garrettsworkshop/MacClassicRAMCard/Documentation/FrontIsom.png

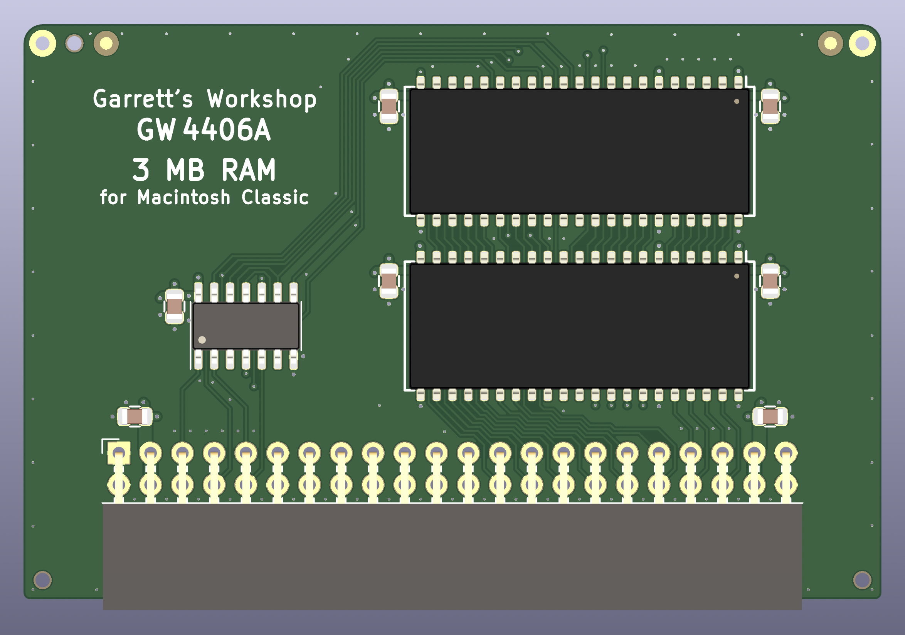
Documentation/FrontIsom.png
