garrettsworkshop/MacClassicRAMCard/Documentation/FrontIsomTransparent.png

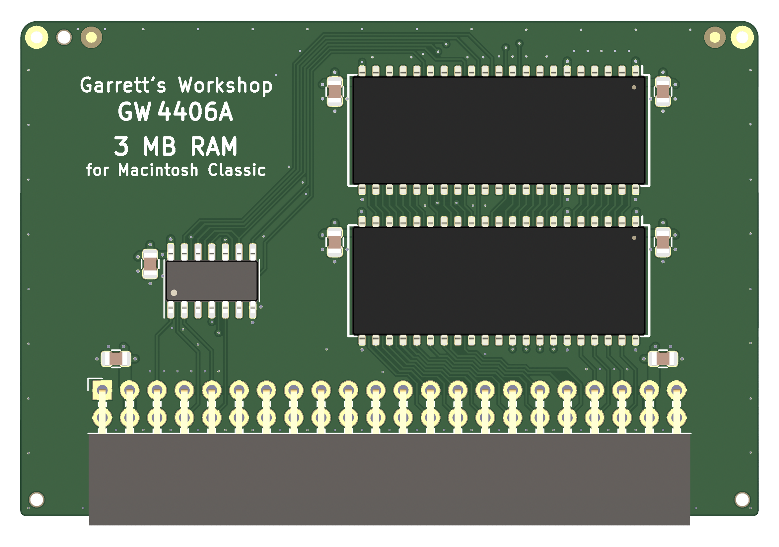
Documentation/FrontIsomTransparent.png
