garrettsworkshop/MacClassicRAMCard/Documentation/NewFrontIsom.png

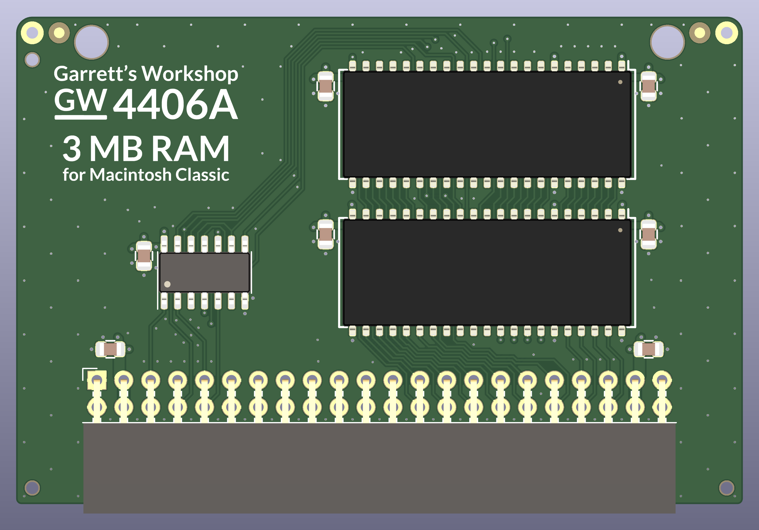
Documentation/NewFrontIsom.png
