garrettsworkshop/MacClassicRAMCard/Documentation/Schematic.png

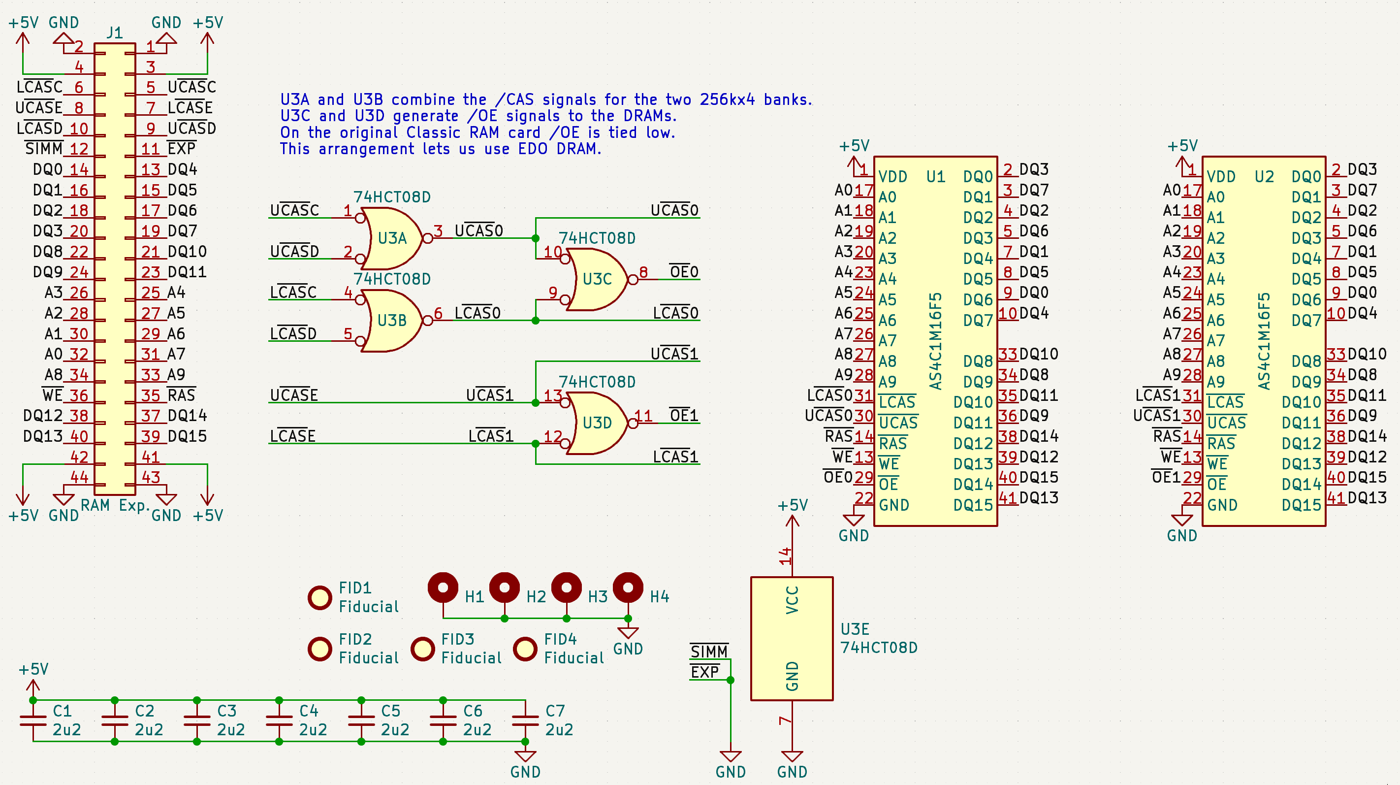
Documentation/Schematic.png
