garrettsworkshop/MacClassicRAMCard/Documentation/Schematic.pdf

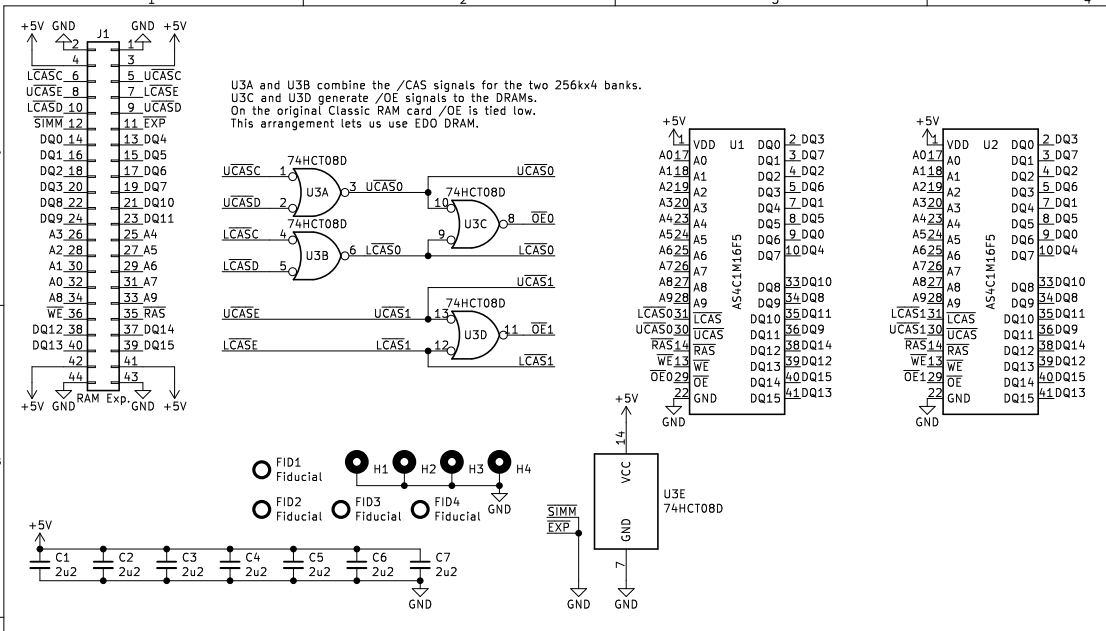
[picture p5: page 1]
