garrettsworkshop/MacClassicRAMCard/MacClassicRAMCard.kicad_pcb

## KiCad design MacClassicRAMCard.kicad_pcb (2022-08-10)

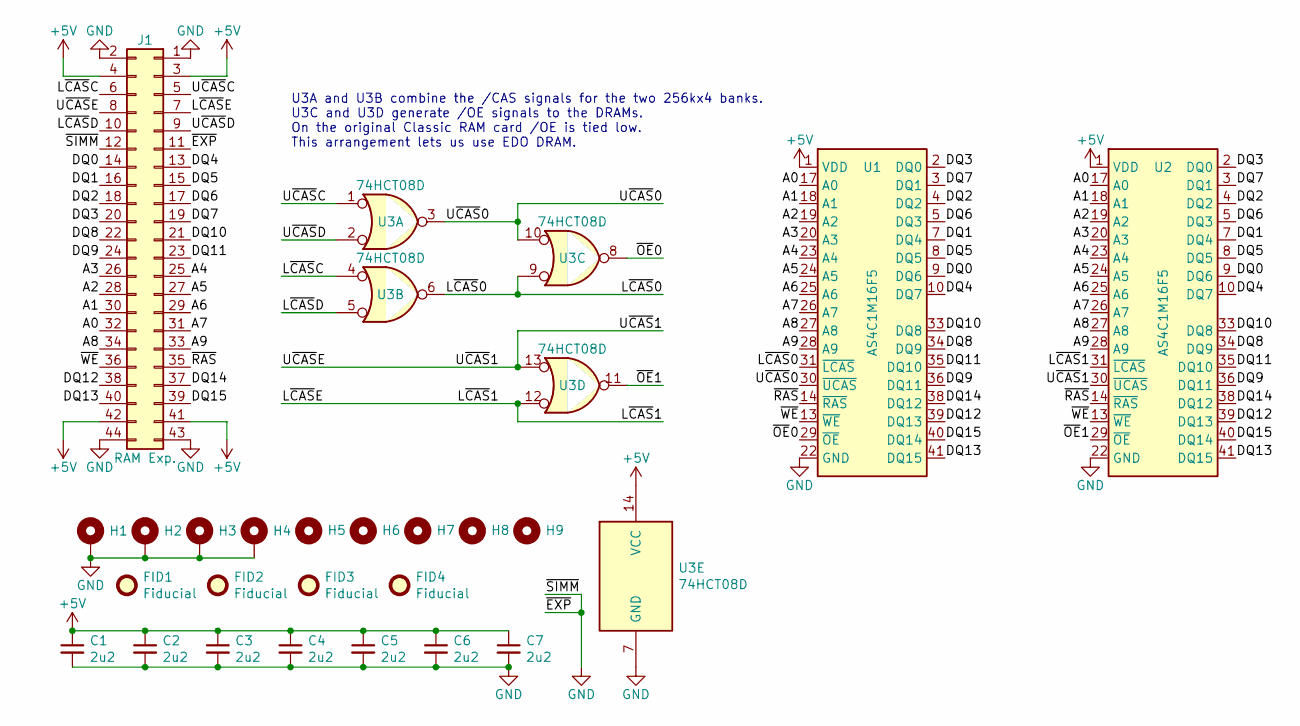
[picture p6: schematic MacClassicRAMCard.kicad_sch, GW4406A]

Parts:
C1, C2, C3, C4, C5, C6, C7: 2u2; C_0805
FID1, FID2, FID3, FID4: Fiducial
H1, H2, H3, H4: PasteHole_1.1mm_PTH
H5, H6, H7: PasteHole_1.152mm_NPTH
H8, H9: PasteHole_3mm_NPTH
J1: RAM Exp.; PinSocket_2x22_P2.54mm_Horizontal
U1, U2: AS4C1M16F5; SOJ-42_400mil
U3: 74HCT08D; SOIC-14_3.9mm

Connections:
+5V: C1.1, C2.1, C3.1, C4.1, C5.1, C6.1, C7.1, J1.3, J1.4, J1.41, J1.42, U1.1 (VDD), U1.6 (VDD), U1.21 (VDD), U2.1 (VDD), U2.6 (VDD), U2.21 (VDD), U3.14 (VCC)
/A0: J1.32, U1.17 (A0), U2.17 (A0)
/A1: J1.30, U1.18 (A1), U2.18 (A1)
/A2: J1.28, U1.19 (A2), U2.19 (A2)
/A3: J1.26, U1.20 (A3), U2.20 (A3)
/A4: J1.25, U1.23 (A4), U2.23 (A4)
/A5: J1.27, U1.24 (A5), U2.24 (A5)
/A6: J1.29, U1.25 (A6), U2.25 (A6)
/A7: J1.31, U1.26 (A7), U2.26 (A7)
/A8: J1.34, U1.27 (A8), U2.27 (A8)
/A9: J1.33, U1.28 (A9), U2.28 (A9)
/DQ0: J1.14, U1.9 (DQ6), U2.9 (DQ6)
/DQ1: J1.16, U1.7 (DQ4), U2.7 (DQ4)
/DQ2: J1.18, U1.4 (DQ2), U2.4 (DQ2)
/DQ3: J1.20, U1.2 (DQ0), U2.2 (DQ0)
/DQ4: J1.13, U1.10 (DQ7), U2.10 (DQ7)
/DQ5: J1.15, U1.8 (DQ5), U2.8 (DQ5)
/DQ6: J1.17, U1.5 (DQ3), U2.5 (DQ3)
/DQ7: J1.19, U1.3 (DQ1), U2.3 (DQ1)
/DQ8: J1.22, U1.34 (DQ9), U2.34 (DQ9)
/DQ9: J1.24, U1.36 (DQ11), U2.36 (DQ11)
/DQ10: J1.21, U1.33 (DQ8), U2.33 (DQ8)
/DQ11: J1.23, U1.35 (DQ10), U2.35 (DQ10)
/DQ12: J1.38, U1.39 (DQ13), U2.39 (DQ13)
/DQ13: J1.40, U1.41 (DQ15), U2.41 (DQ15)
/DQ14: J1.37, U1.38 (DQ12), U2.38 (DQ12)
/DQ15: J1.39, U1.40 (DQ14), U2.40 (DQ14)
/L~CAS0: U1.31 (~LCAS), U3.6, U3.9
/L~CAS1: J1.7, U2.31 (~LCAS), U3.12
/L~CASC: J1.6, U3.4
/L~CASD: J1.10, U3.5
/U~CAS0: U1.30 (~UCAS), U3.3, U3.10
/U~CAS1: J1.8, U2.30 (~UCAS), U3.13
/U~CASC: J1.5, U3.1
/U~CASD: J1.9, U3.2
/~OE0: U1.29 (~OE), U3.8
/~OE1: U2.29 (~OE), U3.11
/~RAS: J1.35, U1.14 (~RAS), U2.14 (~RAS)
/~WE: J1.36, U1.13 (~WE), U2.13 (~WE)
GND: C1.2, C2.2, C3.2, C4.2, C5.2, C6.2, C7.2, H1.1, H2.1, H3.1, H4.1, J1.1, J1.2, J1.11, J1.12, J1.43, J1.44, U1.22 (GND), U1.37 (GND), U1.42 (GND), U2.22 (GND), U2.37 (GND), U2.42 (GND), U3.7 (GND)

Notes on the sheet:
U3A and U3B combine the /CAS signals for the two 256kx4 banks. U3C and U3D generate /OE signals to the DRAMs. On the original Classic RAM card /OE is tied low. This arrangement lets us use EDO DRAM.

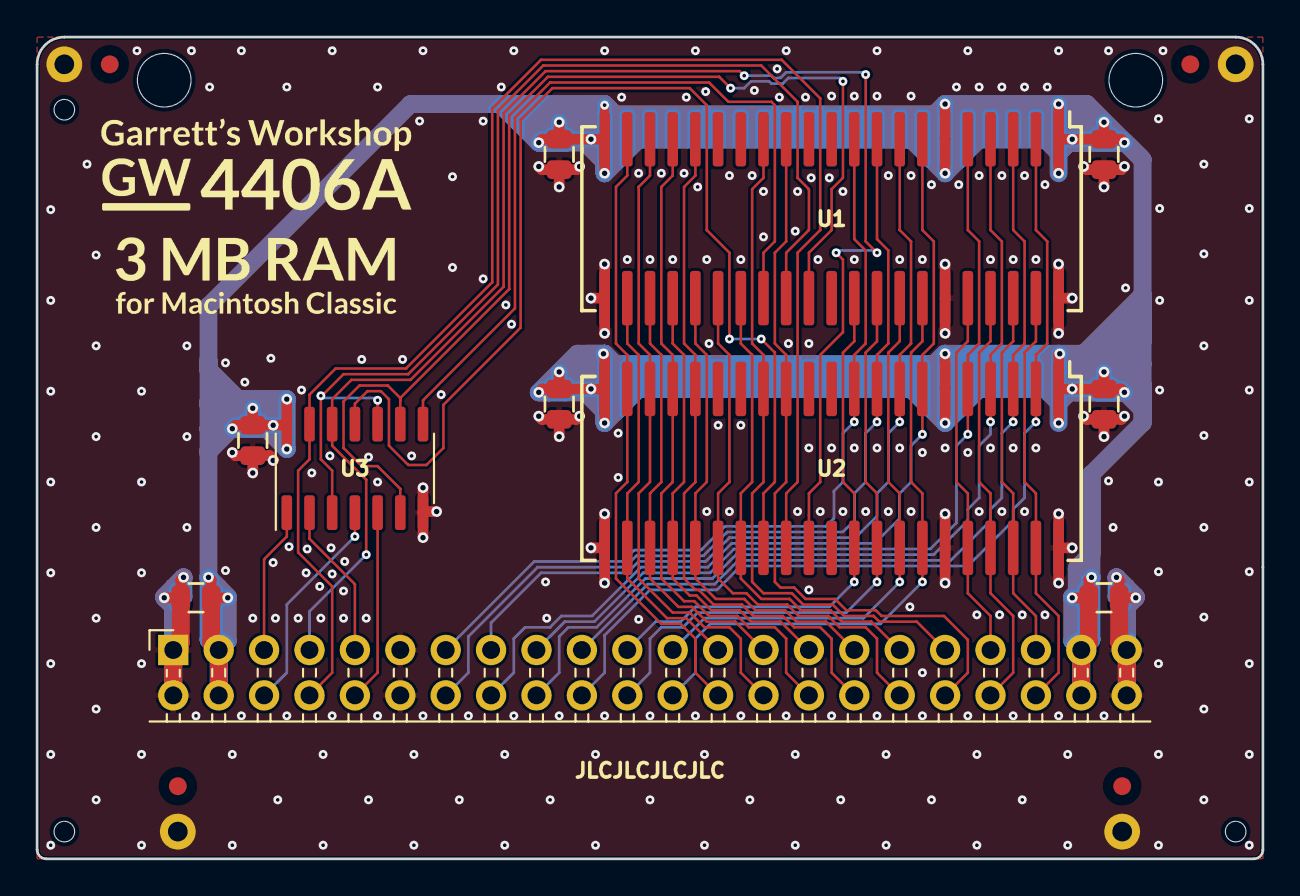
[picture p7: board MacClassicRAMCard.kicad_pcb from above]

Board: 2 copper layers, 68.6 x 46.0 mm, 24 parts (0 on the bottom side), 40 nets.
