garrettsworkshop/MacClassicRAMCard/(commit log)

2021-06-20 Mostly done with layout
    [MacClassicRAMCard.kicad_pcb, MacClassicRAMCard.sch]
2021-10-29 Finished layout I think
    [MacClassicRAMCard.kicad_pcb, MacClassicRAMCard.sch]
2021-11-17 As sent to JLC
    [MacClassicRAMCard-B_Cu.gbl, MacClassicRAMCard-B_Mask.gbs, MacClassicRAMCard-B_SilkS.gbo, MacClassicRAMCard-Edge_Cuts.gm1, MacClassicRAMCard-F_Cu.gtl, MacClassicRAMCard-F_Fab.gbr, MacClassicRAMCard-F_Mask.gts, MacClassicRAMCard-F_Paste.gtp]
2021-11-19 No actually
    [MacClassicRAMCard-B_Cu.gbl, MacClassicRAMCard-B_Mask.gbs, MacClassicRAMCard-B_SilkS.gbo, MacClassicRAMCard-Edge_Cuts.gm1, MacClassicRAMCard-F_Cu.gtl, MacClassicRAMCard-F_Fab.gbr, MacClassicRAMCard-F_Mask.gts, MacClassicRAMCard-F_Paste.gtp]
2022-02-06 Migrate to KiCAD 6
    [MacClassicRAMCard.kicad_pcb, MacClassicRAMCard.kicad_sch, MacClassicRAMCard.sch]
2022-02-06 Switch to KiCAD 6 3d models
    [MacClassicRAMCard.kicad_pcb]
2022-02-11 New prototype
    [MacClassicRAMCard-BOM.csv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]
2022-08-10 New logo
    [MacClassicRAMCard-B_Cu.gbl, MacClassicRAMCard-B_Mask.gbs, MacClassicRAMCard-B_Silkscreen.gbo, MacClassicRAMCard-Edge_Cuts.gm1, MacClassicRAMCard-F_Cu.gtl, MacClassicRAMCard-F_Fab.gbr, MacClassicRAMCard-F_Mask.gts, MacClassicRAMCard-F_Paste.gtp]
